PedroLopes/openEMSstim/apps/README.md

# openEMSstim: open source muscle stimulation using open-source APIs

## Supported platforms & APIs

openEMSstim can be interfaced on virtually anything as long as it has bluetooth (Low Energy) or serial (USB). Here are the languages and libraries for which we have created examples and support code (navigate to each folder to find the examples):

android
(via bluetooth low energy)

unity
(via bluetooth low energy on Unity for Android, or via USB serial)

python
(via USB serial)

nodejs
(via USB serial)

processing
(via bluetooth low energy on Processing Android Mode, or via USB serial)

### Liability

Please refer to the liability waiver (in documentation/liability_waiver.md).
