PedroLopes/openEMSstim/extra/images/android-app/1.a.FindTheNameOfDevice.png

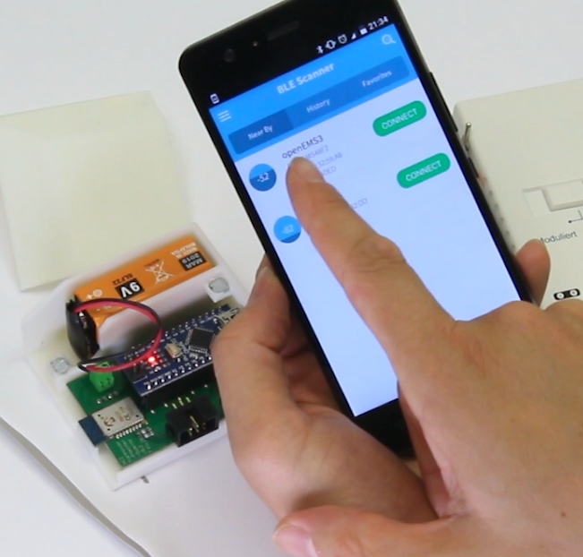
extra/images/android-app/1.a.FindTheNameOfDevice.png
