PedroLopes/openEMSstim/extra/images/android-app/1.c.BlueLEDisOn.png

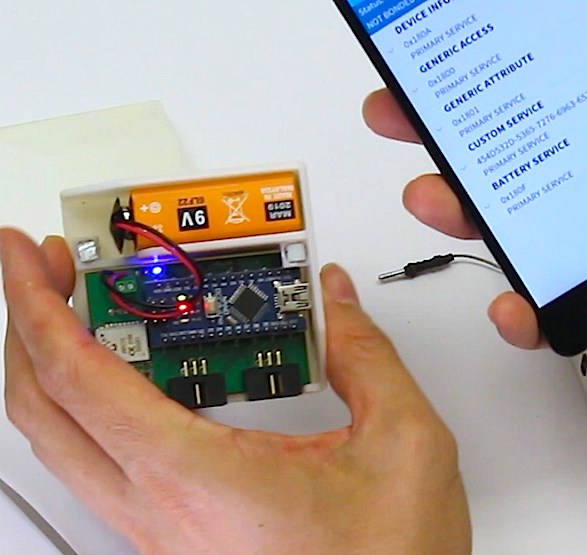
extra/images/android-app/1.c.BlueLEDisOn.png
