PedroLopes/openEMSstim/extra/images/android-app/2.CheckIfNameIsCorrectOnApp.png

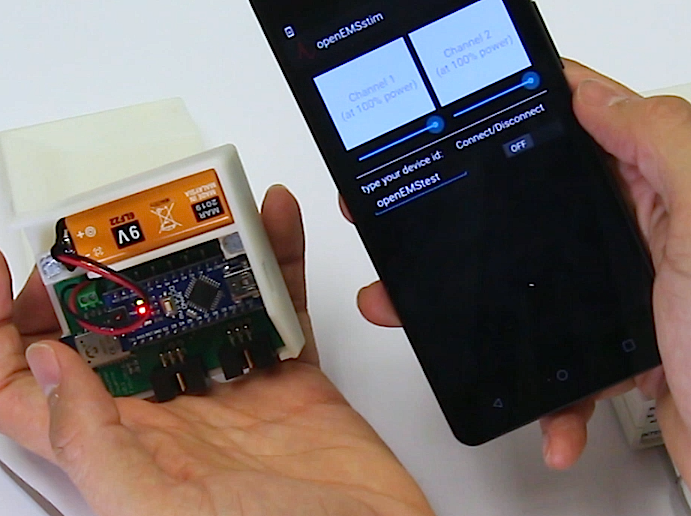
extra/images/android-app/2.CheckIfNameIsCorrectOnApp.png
