PedroLopes/openEMSstim/extra/images/android-app/2.png

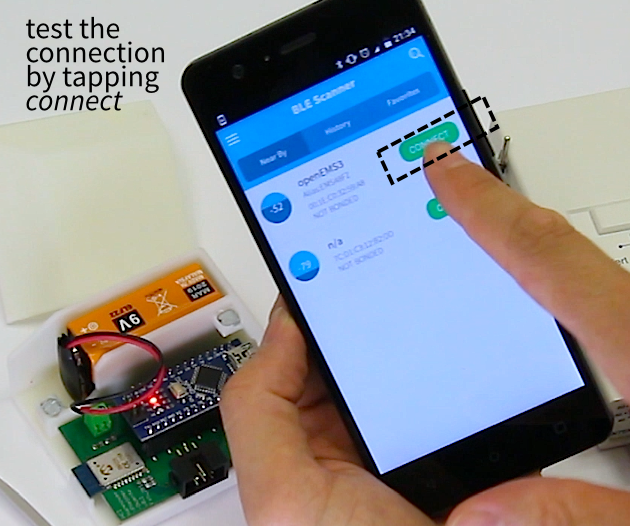
extra/images/android-app/2.png
