PedroLopes/openEMSstim/extra/images/android-app/3.ChangeTheName.png

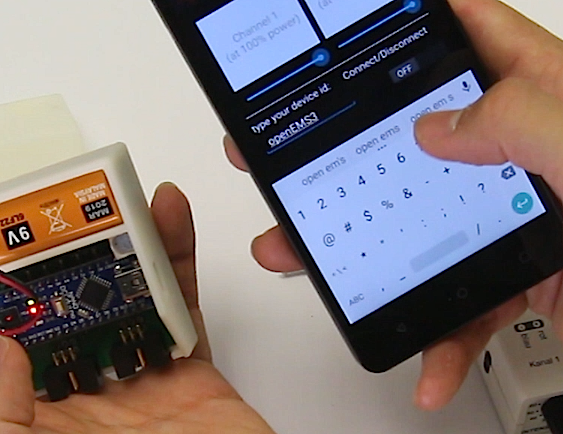
extra/images/android-app/3.ChangeTheName.png
