PedroLopes/openEMSstim/extra/images/android-app/3.png

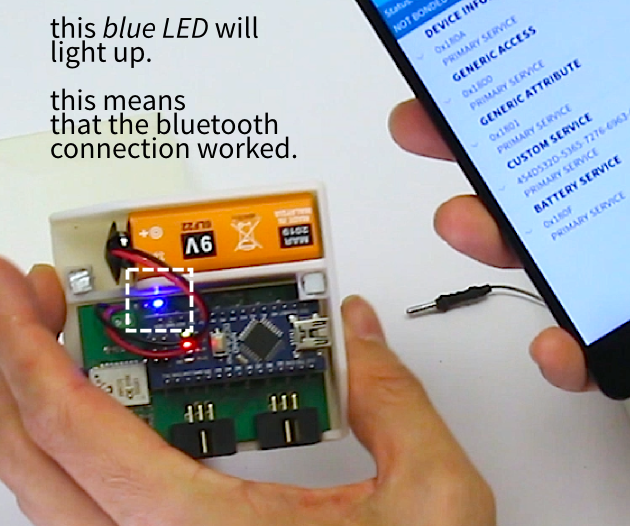
extra/images/android-app/3.png
