PedroLopes/openEMSstim/extra/images/android-app/4.Connect.png

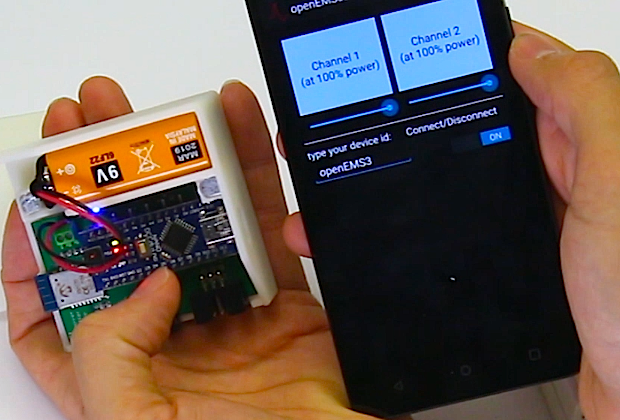
extra/images/android-app/4.Connect.png
