PedroLopes/openEMSstim/extra/images/android-app/8.SlidersIntenisty.png

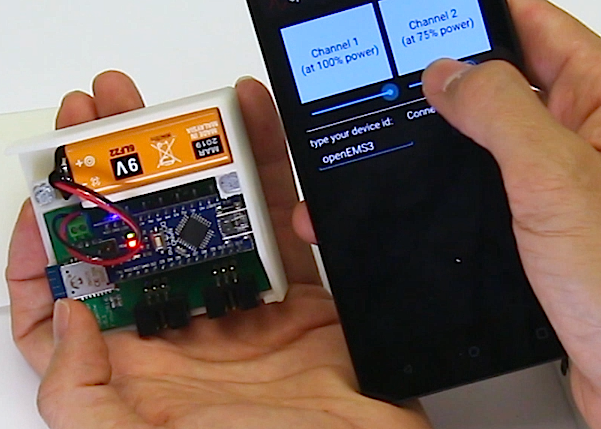
extra/images/android-app/8.SlidersIntenisty.png
