PedroLopes/openEMSstim/extra/images/connection_diagrams/connecting_to_the_board.png

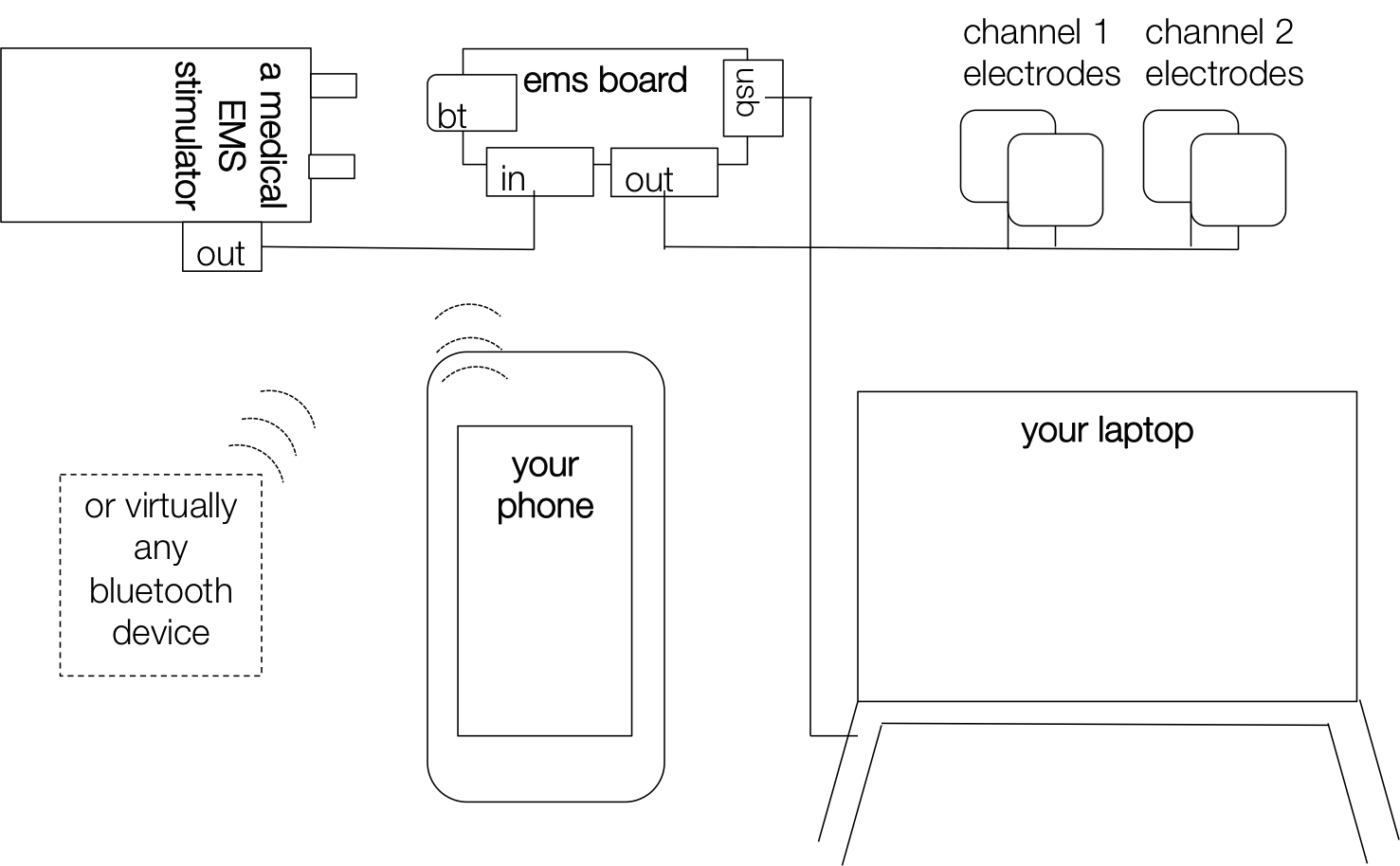
extra/images/connection_diagrams/connecting_to_the_board.png
