PedroLopes/openEMSstim/extra/images/powering-OFF-openEMSstim/IMG_0092.JPG

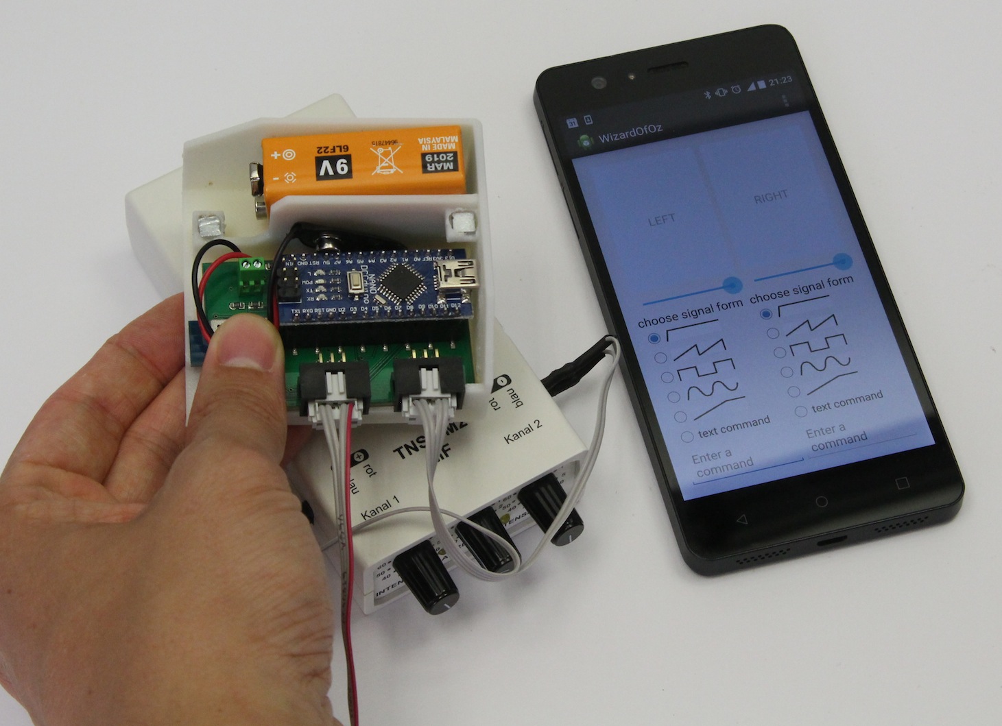
extra/images/powering-OFF-openEMSstim/IMG_0092.JPG
