PedroLopes/openEMSstim/extra/images/powering-ON-openEMSstim/2.CloseTheLid.jpeg

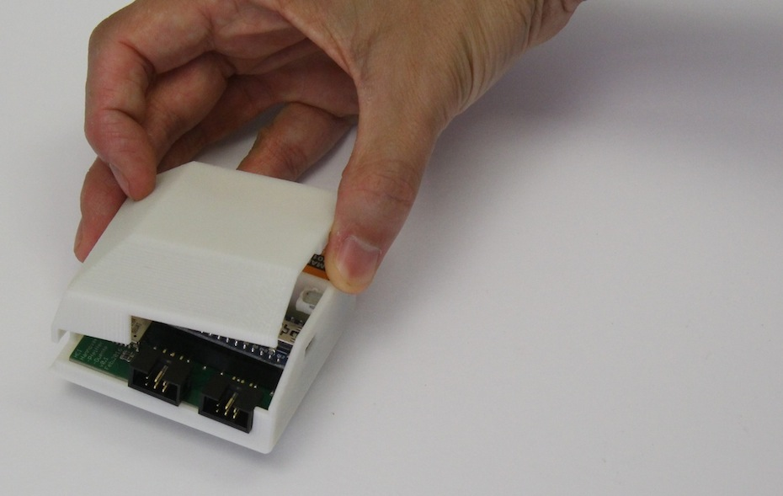
extra/images/powering-ON-openEMSstim/2.CloseTheLid.jpeg
