PedroLopes/openEMSstim/extra/images/powering-ON-openEMSstim/3.openEMSstim_lidClosed.jpeg

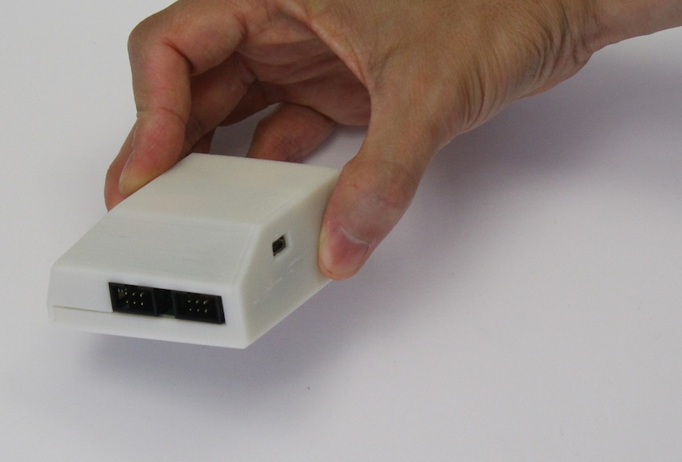
extra/images/powering-ON-openEMSstim/3.openEMSstim_lidClosed.jpeg
