PedroLopes/openEMSstim/hardware/Casings/3dPrintedCasing/top-part.stl

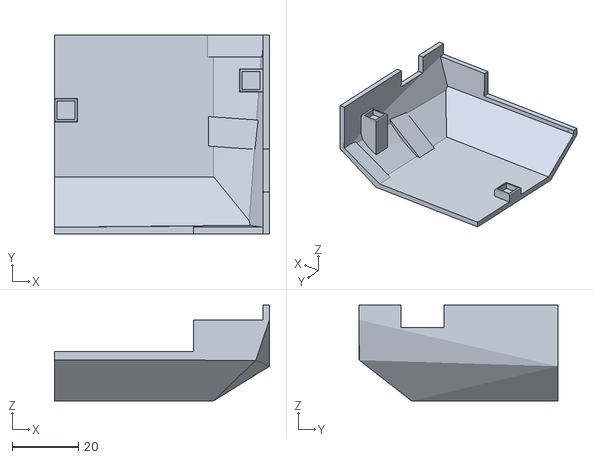
[picture p25: CAD file, 2016-06-14]
hardware/Casings/3dPrintedCasing/top-part.stl
65.0 x 60.0 x 29.0
