PedroLopes/openEMSstim/hardware/Casings/3dPrintedCasing/bottom-part.stl

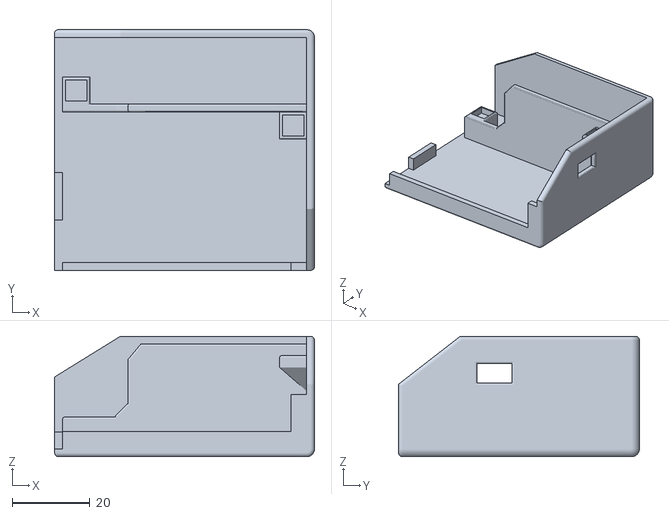
[picture p26: CAD file, 2016-06-14]
hardware/Casings/3dPrintedCasing/bottom-part.stl
67.0 x 62.0 x 31.0
