PedroLopes/openEMSstim/extra/images/building/Connectors.jpg

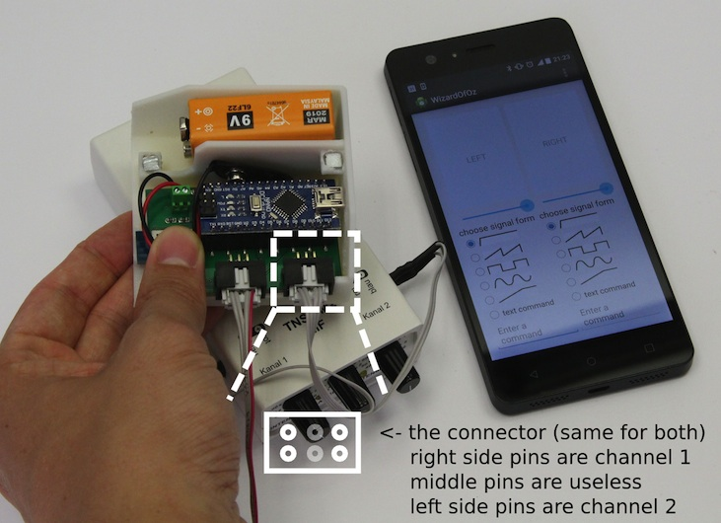
extra/images/building/Connectors.jpg
