PedroLopes/openEMSstim/extra/images/getting-started/2-checking-ID.jpeg

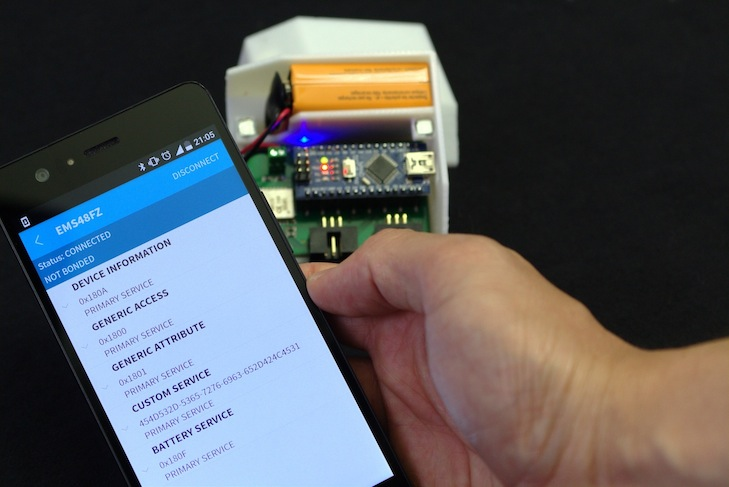
extra/images/getting-started/2-checking-ID.jpeg
