PedroLopes/openEMSstim/extra/images/getting-started/3-conecting-via-Android.jpeg

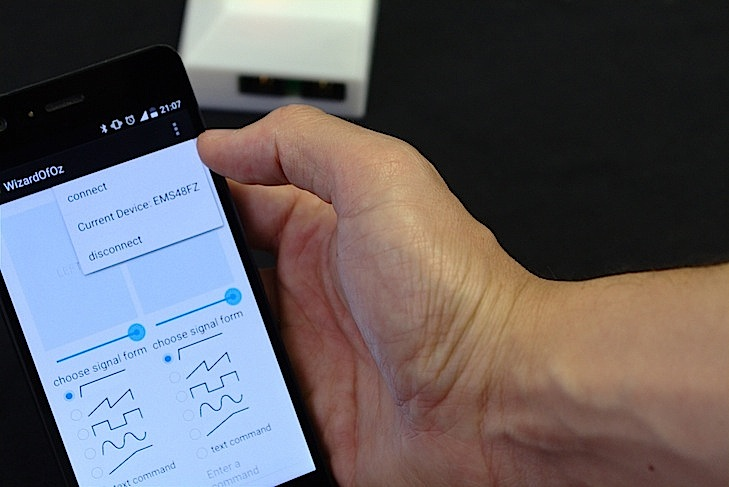
extra/images/getting-started/3-conecting-via-Android.jpeg
