PedroLopes/openEMSstim/extra/images/android-app/1.b.TapConnectToTest.png

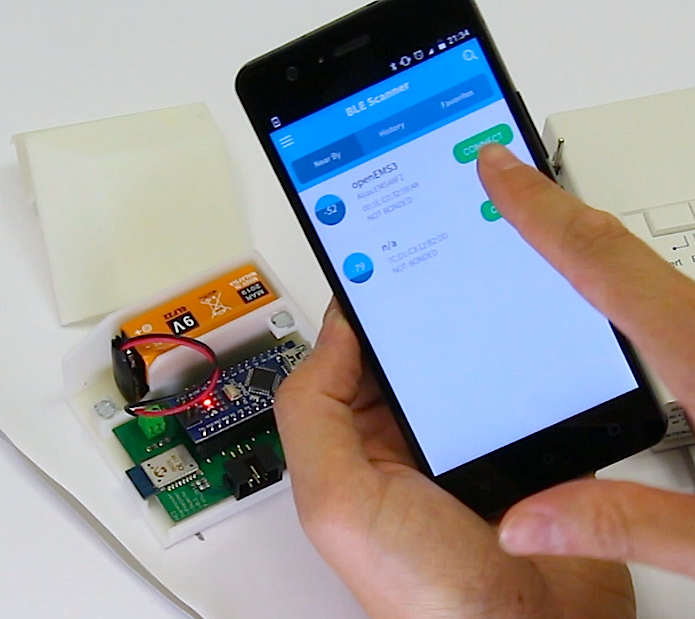
extra/images/android-app/1.b.TapConnectToTest.png
