PedroLopes/openEMSstim/extra/images/android-app/6.TestLEDsForRight.png

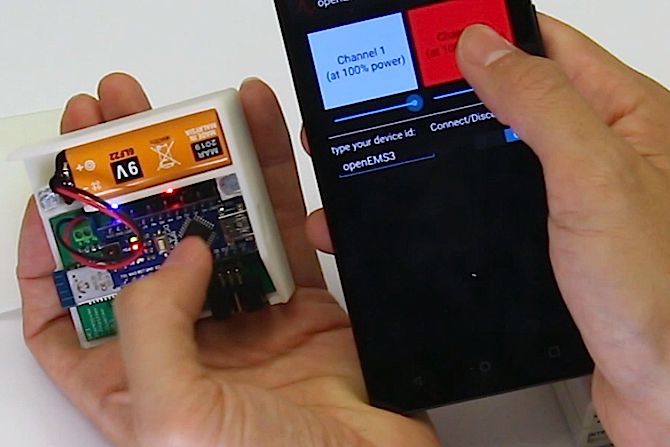
extra/images/android-app/6.TestLEDsForRight.png
