PedroLopes/openEMSstim/extra/images/android-app/7.TestLEDsForLeft.png

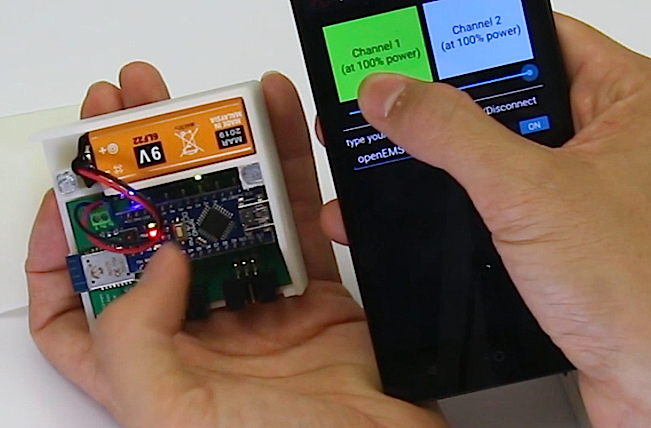
extra/images/android-app/7.TestLEDsForLeft.png
