PedroLopes/openEMSstim/(threads)

Thread 3 (2019-12-16):

Where to buy EMS/TENS device?

gilbertjuly, 2019-12-16:
Hi there, I came across to your project and find this is very nice tutorial indeed!

In terms of getting an EMS/TENS device in "choosing_a_TENS_device.md", I wonder if there is a way to purchase these devices? especially the "TNS SM2" product, I can't find it on the Amazon nor the original link of the product description doesn't exist anymore.

Thank you in advance.

Cheers,
Visiter from China.
