PedroLopes/openEMSstim/apps/python/more-detailed-python-examples/monitor_device_response_via_python.py

from time import sleep
import serial
ser = serial.Serial('/dev/tty.usbserial-A9O3R1XL', 19200) # Establish the connection on a specific port

counter = 32 # Below 32 everything in ASCII is gibberish

while True:
    counter +=1
    ser.write(str(chr(counter))) # Convert the decimal number to ASCII then send it to the Arduino
    print ser.readline() # Read the newest output from the Arduino
    sleep(.1) # Delay for one tenth of a second
    if counter == 255:
        counter = 32
