PedroLopes/openEMSstim/(commit log)

2016-06-14 added cases for the openEMSstim
    [bottom-part.stl, top-part.stl]
2016-06-14 reshuffled dirs and names
    [bottom-part.stl, top-part.stl]
2016-06-16 //#include Arduino_Software.h is it still needed? investigating that as we speak
2016-06-16 //#include Arduino_Software.h was not needed and hanced removed for code simplicity
2016-06-29 added the schematic and board file, based on the original open source version but with some changes
    [EMS_WS_Module_Vertical_V01.brd, EMS_WS_Module_Vertical_V01.sch]
2016-07-01 changed the board, minor change, just a label to orient the arduino while positioning it
    [EMS_WS_Module_Vertical_V01.brd]
2016-07-05 a word on schematics
2016-07-08 changing On_off basics to have two buttons and only one channel
2016-07-08 added a copy of the On_off that works, maybe I can get the two EMS devices, hence four channel, mode working
2016-07-11 changed the arduino to be able to parse direct commands that are not in HEX format, still HEX format is available via USB or BT, on USB it now accepts string commands directly as dictated by protocol
2016-07-12 working on pyEMS module and test case
2016-07-12 cleaned schematics folder
    [openEMSstim_02.brd, openEMSstim_02.sch]
2016-07-14 added intensity information, changed colors, and saved last blutooth device ID
2016-07-14 button colors match the on-board LED colors
2016-07-26 fixed channel number on input string
    [send_without_python_module.py]
2016-08-08 started porting a basic calibrate tool for python
2016-08-12 new calibration routine with commands
2016-08-16 calibration for python now repeats last command
2016-08-16 printing history is incorrect
2016-08-16 printing history is now working
2016-08-19 calibration still undergoing
2016-08-21 working con calibrate
2016-08-24 calibration cleaner now
2016-08-24 added a Bill of Materials
2016-08-24 bill of materials updated
2016-09-15 calibrate is not complete but these classes were missing
    [channel.py]
2016-09-16 preset had a bug
    [channel.py]
2016-12-16 new board design V3: not tested yet
    [openEMSstim_03.brd, openEMSstim_03.sch]
2017-01-24 fixed bug on tester sinhgle-char commands
    [arduino-openEMSstim.ino]
2017-02-01 more info on switch and diode
2017-02-01 image for switch
