PedroLopes/openEMSstim/(notices)

Notices in the files:
arduino-openEMSstim/Rn4020BTLe.h:
Copyright 2016 by Tim DÃ¼nte <tim.duente@hci.uni-hannover.de>
Licensed under "The MIT License (MIT) â€“ military use of this product is forbidden â€“ V 0.2".
@license "The MIT License (MIT) â€“ military use of this product is forbidden â€“ V 0.2"
parts and their libraries:
SparkFun-Passives: Licensing: Creative Commons ShareAlike 4.0 International - https://creativecommons.org/licenses/by-sa/4.0
